YamamotoWorksDev/C4NDY_STM32G4_Dev_Board/c4ndy-main-revg-ioexplain.jpg

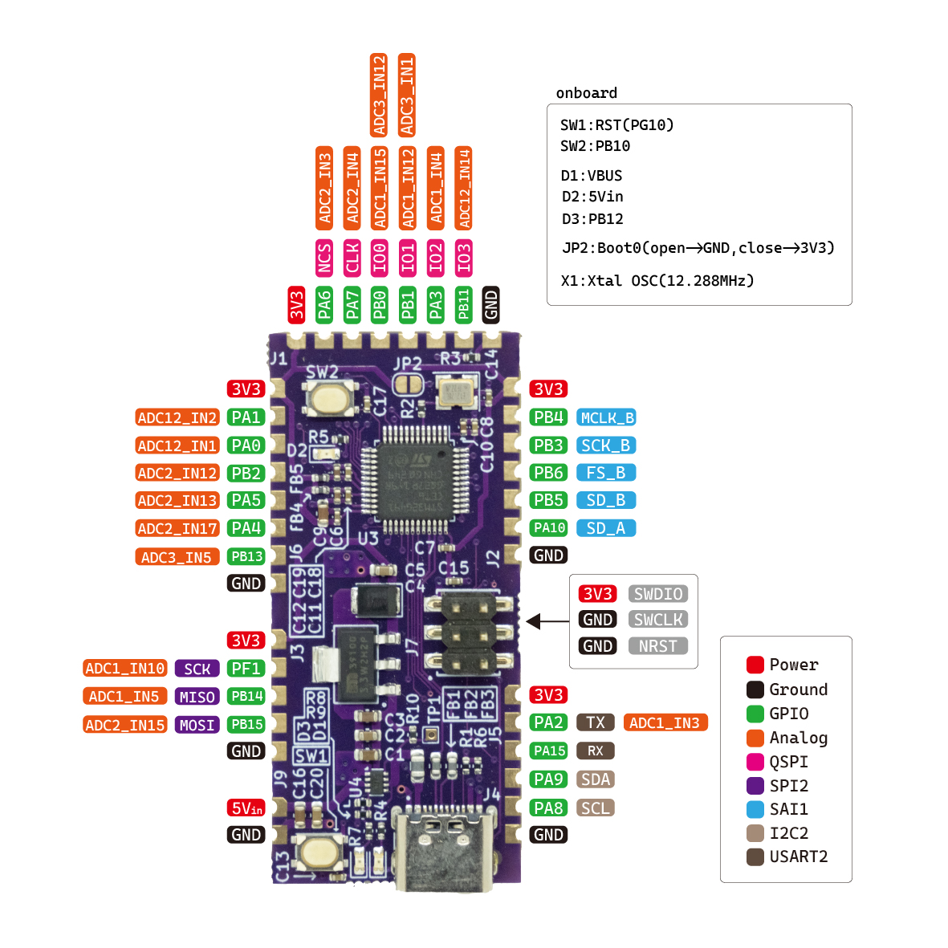
c4ndy-main-revg-ioexplain.jpg
