YamamotoWorksDev/C4NDY_STM32G4_Dev_Board/README.md

# C4NDY STM32G4 Development Board
This board is a development board featuring the STM32G491CET6 microcontroller.

Despite its compact size, it supports up to 16 analog inputs and offers a wide range of peripherals including I2C, SPI, USART, QSPI, and SAI. Furthermore, its USB full-speed capability enables development not only for USB keyboards and MIDI controllers but also for simple USB audio devices.

## how to buy
[Yamamoto Works Ltd. Online Store](https://miyworks.base.shop/items/130799898)

## specifications
- STM32G491CET6(Arm Cortex-M4/170MHz max)
- External Crystal Oscilator(12.288MHz)
- USB Fullspeed
- USB Bus power & Self power(max 5.5V)
- [USB bootloader](https://github.com/YamamotoWorksDev/C4NDY_STM32G4_Dev_Board/tree/main/STM32CubeIDE/C4NDY_BTL)

## example products
[C4NDY KeyVLM/STK](https://yamamo2shun1.github.io/C4NDY/)

## pinout
c4ndy-main-revg-ioexplain

## size
c4ndy-main-revg-size
