YamamotoWorksDev/C4NDY_STM32G4_Dev_Board/c4ndy-main-revg-sch.pdf

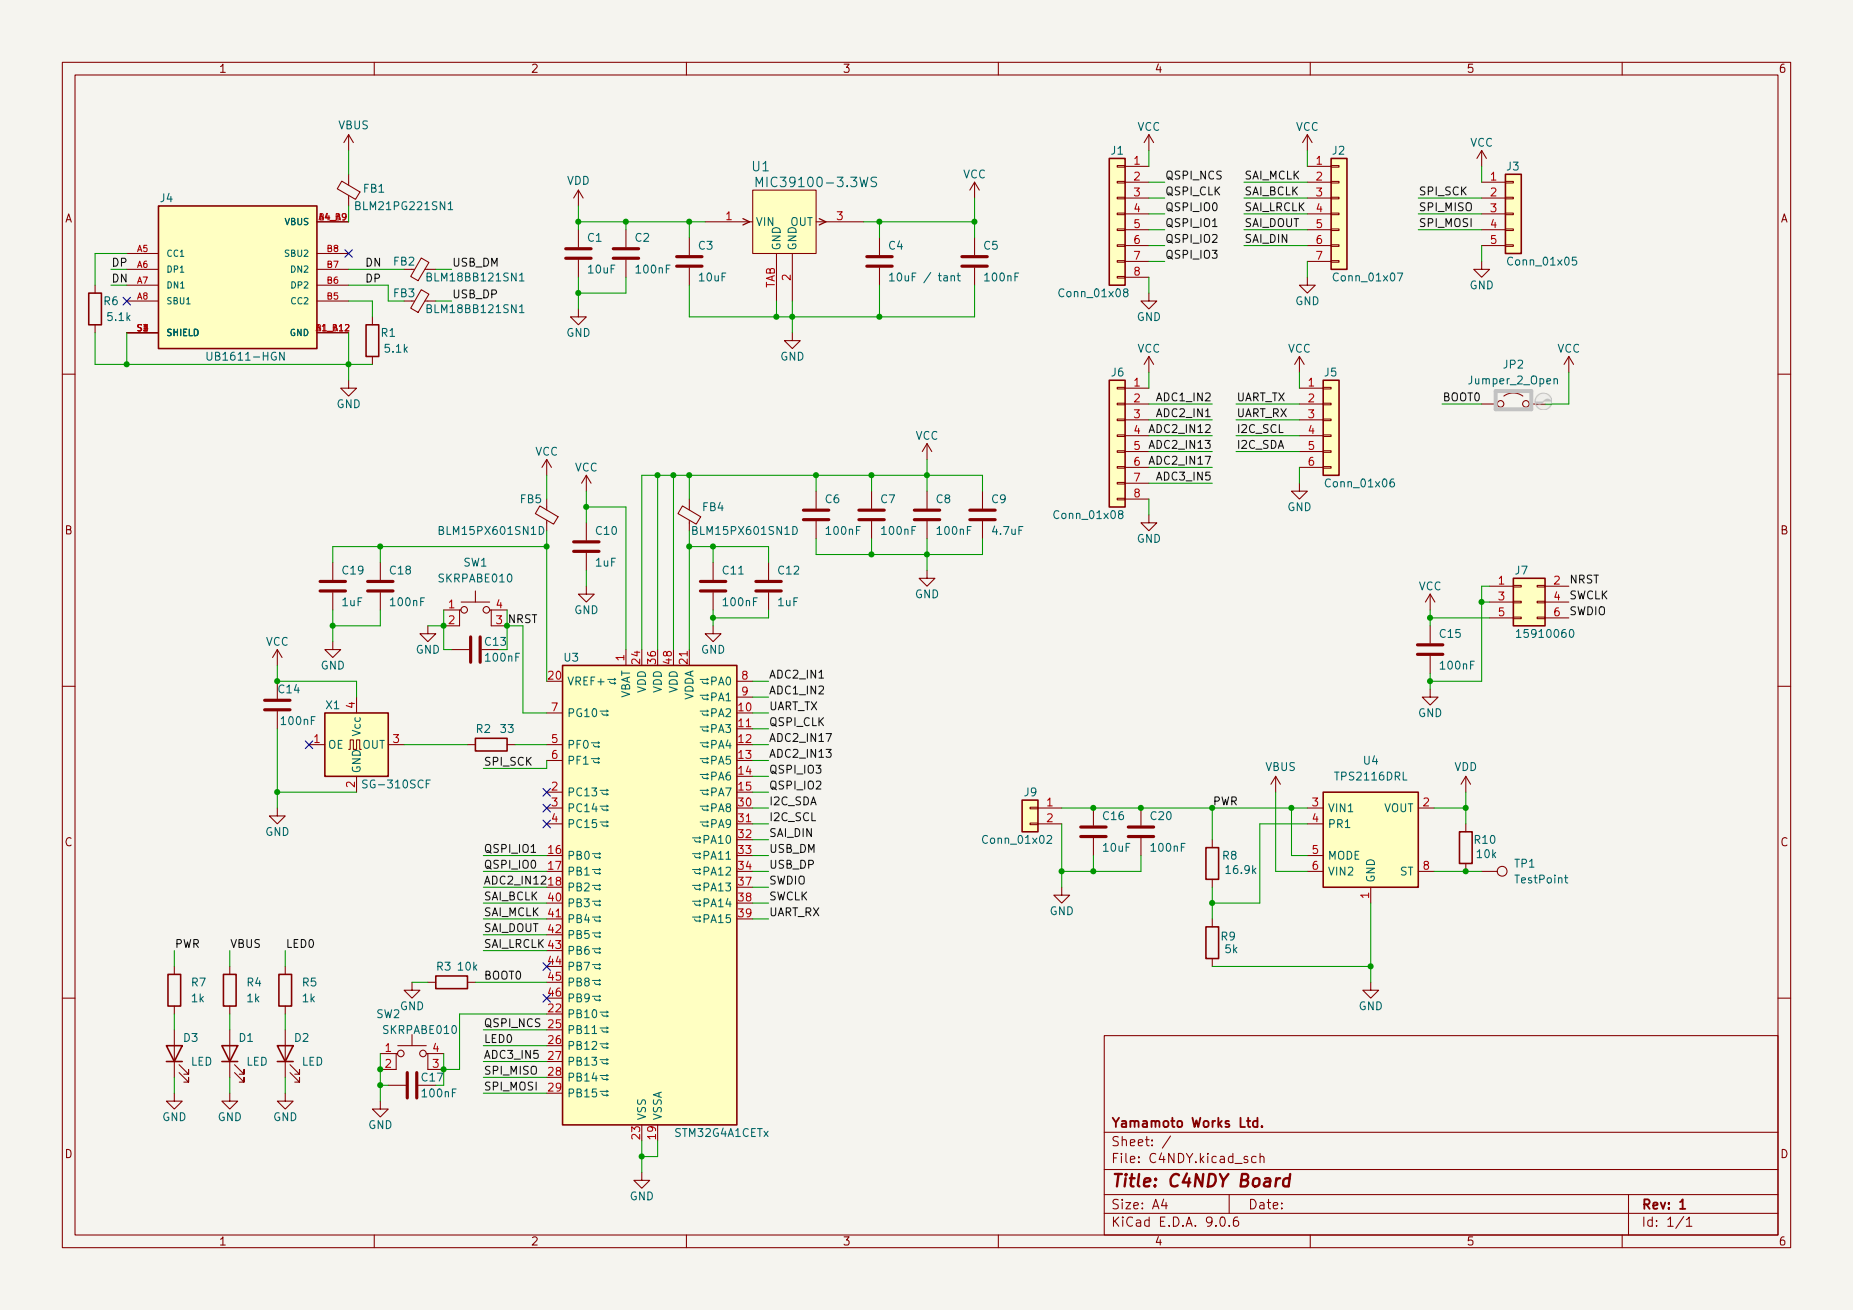
[picture p3: page 1]
