YamamotoWorksDev/C4NDY_STM32G4_Dev_Board/KiCad/C4NDY_mainboard/C4NDY.kicad_pcb

## KiCad design KiCad/C4NDY_mainboard/C4NDY.kicad_pcb (2026-01-06)

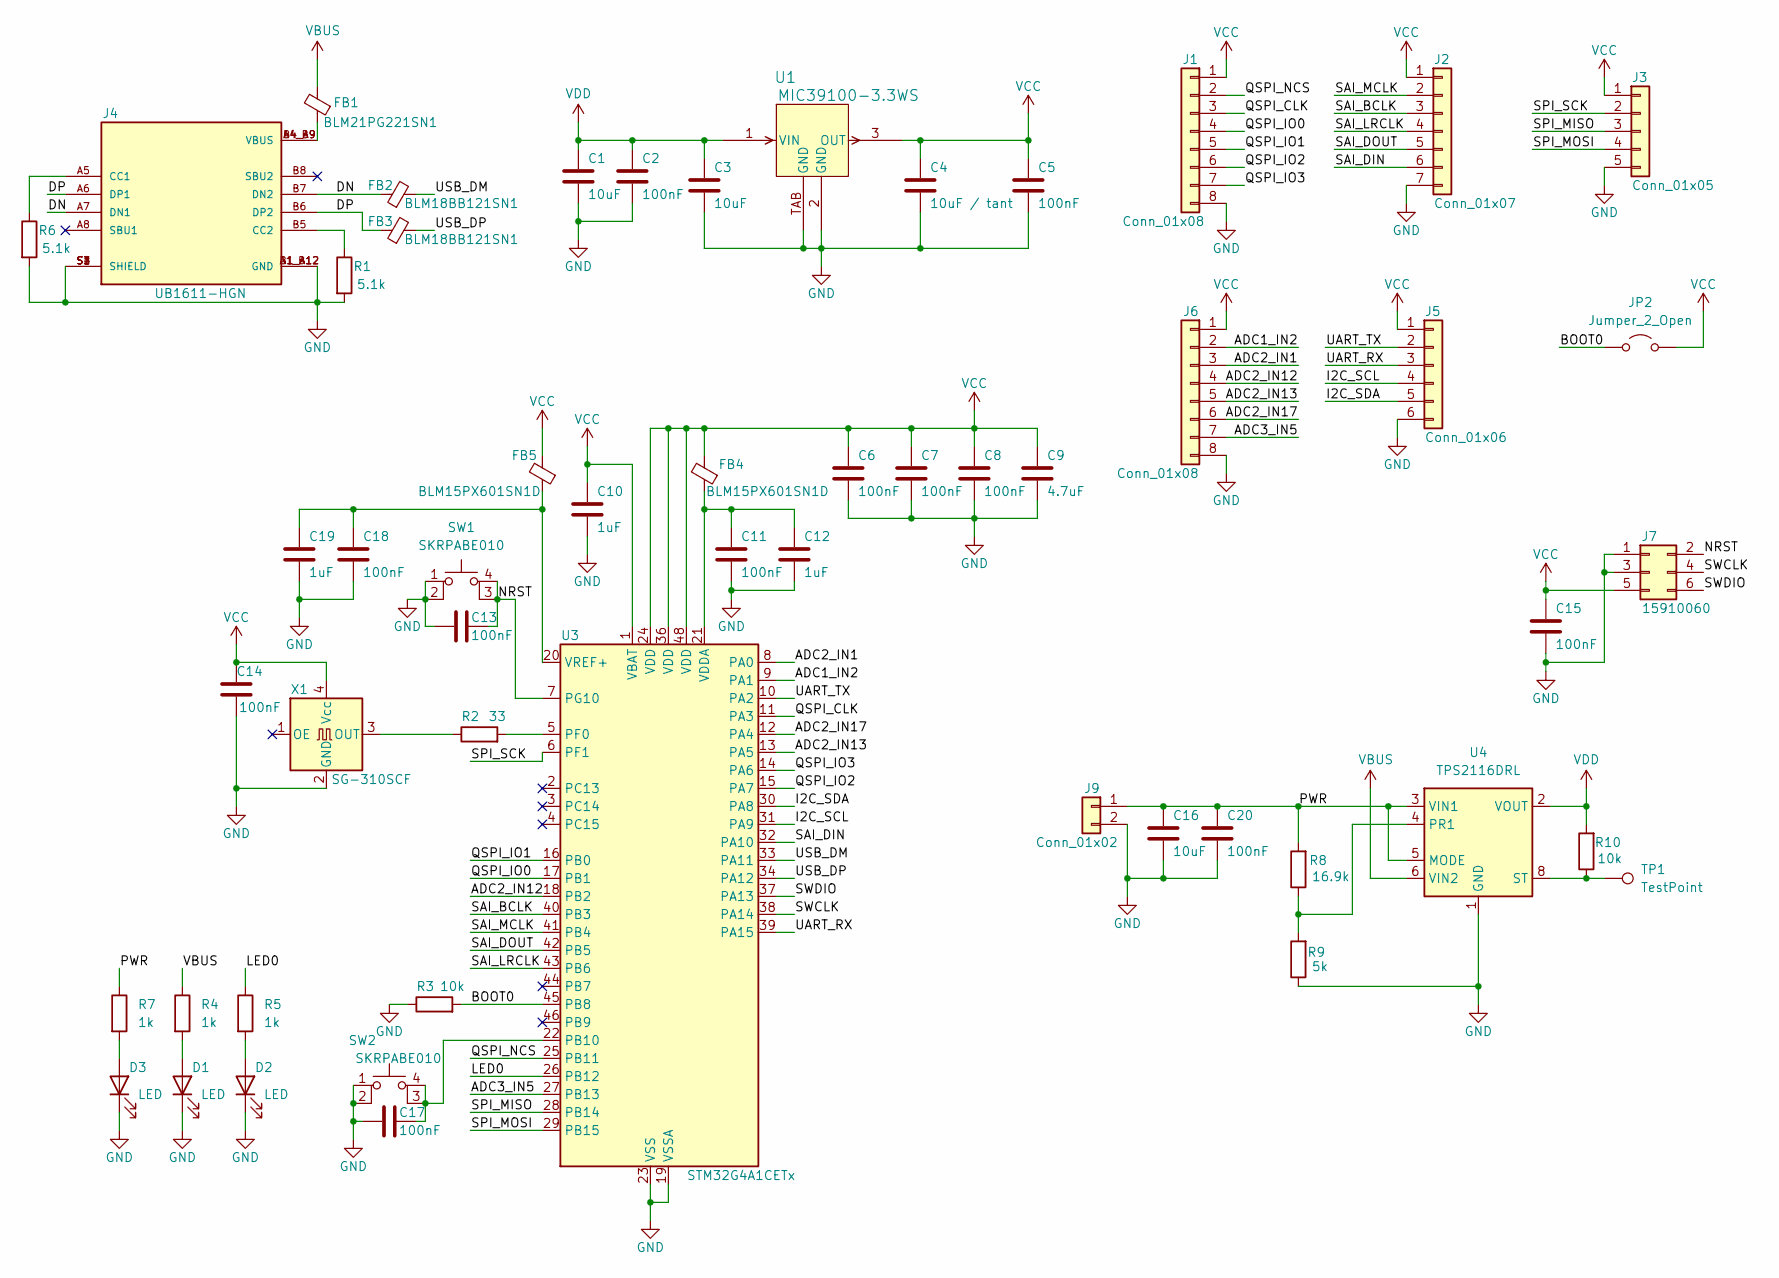
[picture p4: schematic C4NDY.kicad_sch, C4NDY Board]

Parts:
C1, C3, C16: 10uF; C_0603_1608Metric
C2, C5, C20: 100nF; C_0603_1608Metric
C4: 10uF / tant; CP_EIA-3528-12_Kemet-T
C6, C7, C8, C11, C13, C14, C15, C17, C18: 100nF; C_0402_1005Metric
C9: 4.7uF; C_0603_1608Metric
C10, C12, C19: 1uF; C_0402_1005Metric
D1, D2, D3: LED; LED_0603_1608Metric
FB1: BLM21PG221SN1; L_0805_2012Metric
FB2, FB3: BLM18BB121SN1; L_0603_1608Metric
FB4, FB5: BLM15PX601SN1D; L_0402_1005Metric
J1, J6: Conn_01x08; PinHeader_1x08_P2.54mm_Vertical
J2: Conn_01x07; PinHeader_1x07_P2.54mm_Vertical
J3: Conn_01x05; PinHeader_1x05_P2.54mm_Vertical
J4: UB1611-HGN; Gangyuan_UB1611-HGN; PARTREV B
J5: Conn_01x06; PinHeader_1x06_P2.54mm_Vertical
J7: 15910060; Molex_15910060
J9: Conn_01x02; PinHeader_1x02_P2.54mm_Vertical
JP2: Jumper_2_Open; SolderJumper-2_P1.3mm_Open_RoundedPad1.0x1.5mm
R1, R6: 5.1k; R_0402_1005Metric
R2: 33; R_0402_1005Metric
R3, R10: 10k; R_0402_1005Metric
R4, R5, R7: 1k; R_0402_1005Metric
R8: 16.9k; R_0402_1005Metric
R9: 5k; R_0402_1005Metric
SW1, SW2: SKRPABE010
TP1: TestPoint; TestPoint_THTPad_1.0x1.0mm_Drill0.5mm
U1: MIC39100-3.3WS; SOT-223_S_MCL
U3: STM32G4A1CETx; LQFP-48_7x7mm_P0.5mm
U4: TPS2116DRL; SOT-583-8
X1: SG-310SCF; Oscillator_SMD_SeikoEpson_SG8002CE-4Pin_3.2x2.5mm

Connections:
/ADC1_IN2: J6.2, U3.9 (PA1)
/ADC2_IN1: J6.3, U3.8 (PA0)
/ADC2_IN12: J6.4, U3.18 (PB2)
/ADC2_IN13: J6.5, U3.13 (PA5)
/ADC2_IN17: J6.6, U3.12 (PA4)
/ADC3_IN5: J6.7, U3.27 (PB13)
/BOOT0: JP2.1 (A), R3.2, U3.45 (PB8)
/DN: FB2.1, J4.A7 (DN1), J4.B7 (DN2)
/DP: FB3.1, J4.A6 (DP1), J4.B6 (DP2)
/I2C_SCL: J5.4, U3.31 (PA9)
/I2C_SDA: J5.5, U3.30 (PA8)
/LED0: R5.1, U3.26 (PB12)
/NRST: C13.1, J7.2, SW1.3 (K), SW1.4 (A), U3.7 (PG10)
/PWR: C16.1, C20.1, J9.1, R7.1, R8.2, U4.3 (VIN1), U4.5 (MODE)
/QSPI_CLK: J1.3, U3.11 (PA3)
/QSPI_IO0: J1.4, U3.17 (PB1)
/QSPI_IO1: J1.5, U3.16 (PB0)
/QSPI_IO2: J1.6, U3.15 (PA7)
/QSPI_IO3: J1.7, U3.14 (PA6)
/QSPI_NCS: J1.2, U3.25 (PB11)
/SAI_BCLK: J2.3, U3.40 (PB3)
/SAI_DIN: J2.6, U3.32 (PA10)
/SAI_DOUT: J2.5, U3.42 (PB5)
/SAI_LRCLK: J2.4, U3.43 (PB6)
/SAI_MCLK: J2.2, U3.41 (PB4)
/SPI_MISO: J3.3, U3.28 (PB14)
/SPI_MOSI: J3.4, U3.29 (PB15)
/SPI_SCK: J3.2, U3.6 (PF1)
/SWCLK: J7.4, U3.38 (PA14)
/SWDIO: J7.6, U3.37 (PA13)
/UART_RX: J5.3, U3.39 (PA15)
/UART_TX: J5.2, U3.10 (PA2)
/USB_DM: FB2.2, U3.33 (PA11)
/USB_DP: FB3.2, U3.34 (PA12)
GND: C1.2, C2.2, C3.2, C4.2, C5.2, C6.2, C7.2, C8.2, C9.2, C10.2, C11.2, C12.2, C13.2, C14.1, C15.2, C16.2, C17.2, C18.2, C19.2, C20.2, D1.1 (K), D2.1 (K), D3.1 (K), J1.8, J2.7, J3.5, J4.A1_B12 (GND), J4.B1_A12 (GND), J4.S1 (SHIELD), J4.S2 (SHIELD), J4.S3 (SHIELD), J4.S4 (SHIELD), J5.6, J6.8, J7.1, J7.3, J9.2, R1.2, R3.1, R6.2, R9.1, SW1.1, SW1.2, SW2.1, SW2.2, U1.2 (GND), U1.TAB (GND), U3.19 (VSSA), U3.23 (VSS), U3.35 (VSS), U3.47 (VSS), U4.1 (GND), X1.2 (GND)
unnamed: D1.2 (A), R4.2
unnamed: D2.2 (A), R5.2
unnamed: D3.2 (A), R7.2
unnamed: FB1.1, J4.A4_B9 (VBUS), J4.B4_A9 (VBUS)
unnamed: J4.A5 (CC1), R6.1
unnamed: J4.B5 (CC2), R1.1
unnamed: C17.1, SW2.3 (K), SW2.4 (A), U3.22 (PB10)
unnamed: R2.2, U3.5 (PF0)
unnamed: C11.1, C12.1, FB4.1, U3.21 (VDDA)
unnamed: C18.1, C19.1, FB5.1, U3.20 (VREF+)
unnamed: R8.1, R9.2, U4.4 (PR1)
unnamed: R10.1, TP1.1, U4.8 (ST)
unnamed: R2.1, X1.3 (OUT)
VBUS: FB1.2, R4.1, U4.6 (VIN2)
VCC: C4.1, C5.1, C6.1, C7.1, C8.1, C9.1, C10.1, C14.2, C15.1, FB4.2, FB5.2, J1.1, J2.1, J3.1, J5.1, J6.1, J7.5, JP2.2 (B), U1.3 (OUT), U3.1 (VBAT), U3.24 (VDD), U3.36 (VDD), U3.48 (VDD), X1.4 (Vcc)
VDD: C1.1, C2.1, C3.1, R10.2, U1.1 (VIN), U4.2 (VOUT), U4.7 (VOUT)

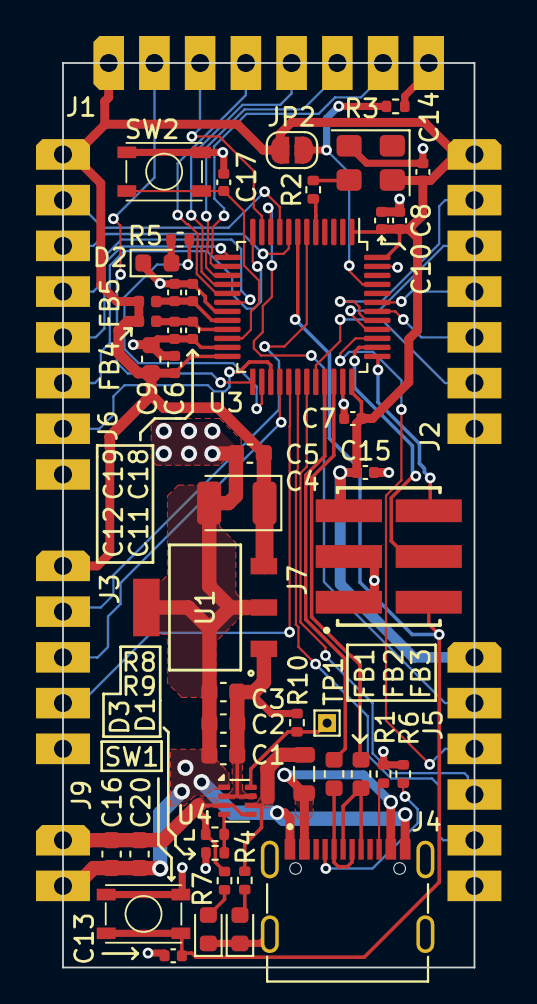
[picture p5: board C4NDY.kicad_pcb from above]

Board: 2 copper layers, 22.9 x 50.2 mm, 54 parts (0 on the bottom side), 51 nets.
