YamamotoWorksDev/C4NDY_STM32G4_Dev_Board/STM32CubeIDE/C4NDY_BTL/C4NDY_BTL.ioc

Mcu.UserName=STM32G491CETx
PA0.Signal=SharedAnalog_PA0
PA1.Signal=SharedAnalog_PA1
PA11.Signal=USB_DM
PA12.Signal=USB_DP
PA13.Signal=SYS_JTMS-SWDIO
PA14.Signal=SYS_JTCK-SWCLK
PA15.GPIO_Label=CODEC_RST
PA15.Signal=GPIO_Output
PA3.Signal=QUADSPI1_CLK
PA6.Signal=QUADSPI1_BK1_IO3
PA7.Signal=QUADSPI1_BK1_IO2
PA8.Signal=I2C2_SDA
PA9.Signal=I2C2_SCL
PB0.Signal=QUADSPI1_BK1_IO1
PB1.Signal=QUADSPI1_BK1_IO0
PB10.GPIO_Label=USER_SW
PB10.Signal=GPIO_Input
PB11.Signal=QUADSPI1_BK1_NCS
PB12.GPIO_Label=USER_LED
PB12.Signal=GPIO_Output
PB3.Signal=SAI1_SCK_B
PB4.Signal=SAI1_MCLK_B
PB5.Signal=SAI1_SD_B
PB6.Signal=SAI1_FS_B
PB7.GPIO_Label=HC165_SL
PB7.Signal=GPIO_Output
PB9.GPIO_Label=HC165_QH
PB9.Signal=GPIO_Input
PC13.GPIO_Label=HC164_CLK
PC13.Signal=GPIO_Output
PC14-OSC32_IN.GPIO_Label=HC164_A
PC14-OSC32_IN.Signal=GPIO_Output
PC15-OSC32_OUT.GPIO_Label=HC165_CLK
PC15-OSC32_OUT.Signal=GPIO_Output
PF0-OSC_IN.Signal=RCC_OSC_IN
