YamamotoWorksDev/C4NDY_STM32G4_Dev_Board/STM32CubeIDE/LED_BLINK/Core/Inc/main.h

#define SW2_Pin GPIO_PIN_10
#define SW2_GPIO_Port GPIOB
#define LED3_Pin GPIO_PIN_12
#define LED3_GPIO_Port GPIOB
