YamamotoWorksDev/C4NDY_STM32G4_Dev_Board/(commit log)

2026-01-06 .gitignoreを追加
2026-01-06 Kicadプロジェクト一式を追加
    [C4NDY.kicad_pcb, C4NDY.kicad_sch]
2026-01-06 ピン配置の説明画像を追加
2026-01-06 回路図のPDFを追加
2026-01-06 基板の寸法図画像を追加
2026-01-06 ブートローダのプロジェクト一式を追加
2026-01-06 サンプルコードのプロジェクトを追加
2026-01-06 不要なコードを削除
2026-01-06 ブートローダー経由で動くように開始アドレスを修正
2026-01-06 外部クロックの値を実装されている発振器のクロックにする
2026-01-06 Lチカさせる
2026-01-06 Revise README for C4NDY STM32G4 Development Board
    Updated the README to improve clarity and add details about the board's features, buying options, specifications, example products, and included an image.
