YamamotoWorksDev/C4NDY_STM32G4_Dev_Board/(notices)

Notices in the files:
STM32CubeIDE/LED_BLINK/Core/Inc/main.h:
Copyright (c) 2026 STMicroelectronics.
All rights reserved.
This software is licensed under terms that can be found in the LICENSE file
